wayri/KERO/previews/board-3d.png

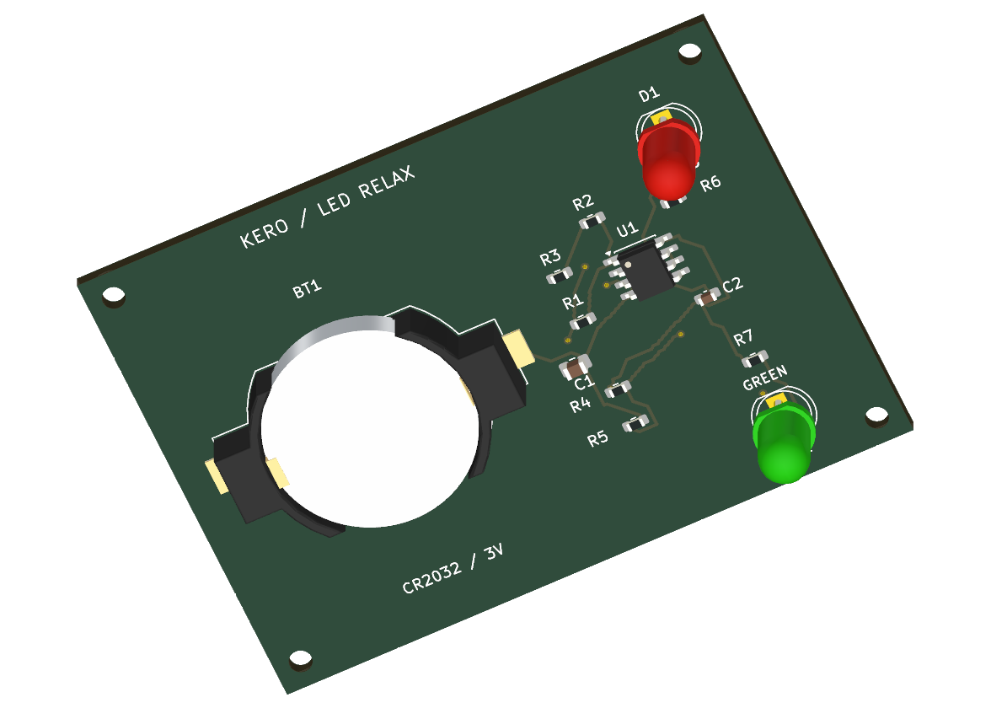
previews/board-3d.png
