wayri/KERO/previews/schematic-browser.png

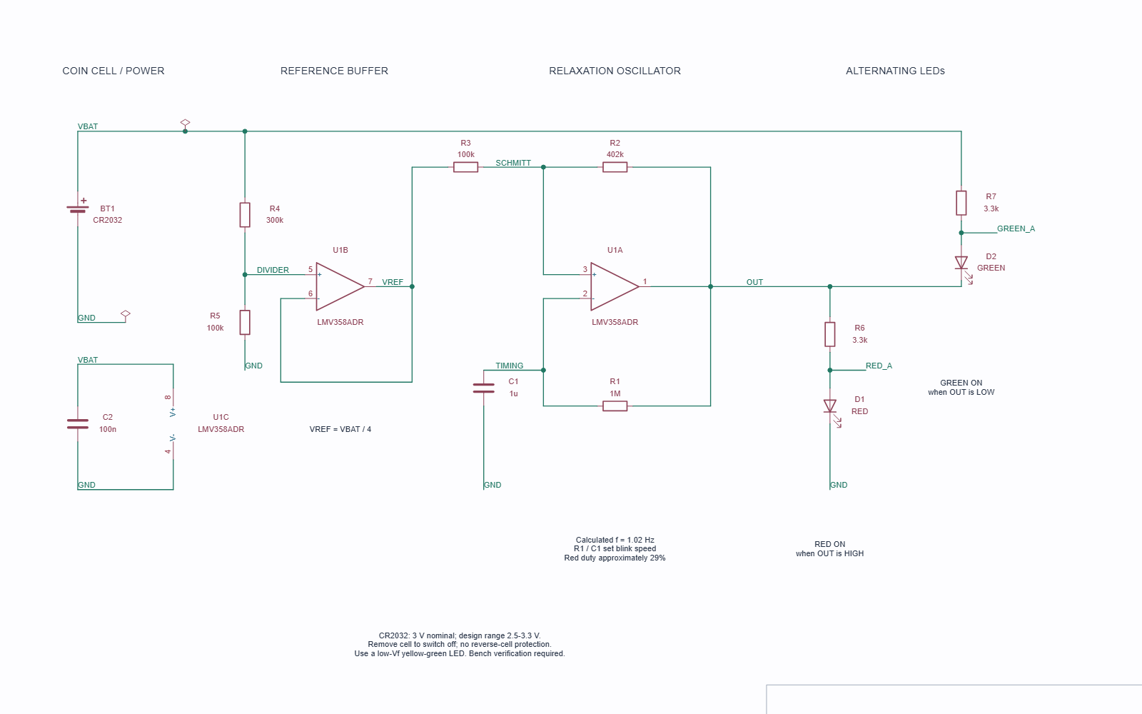
previews/schematic-browser.png
