wayri/KERO/previews/schematic.png

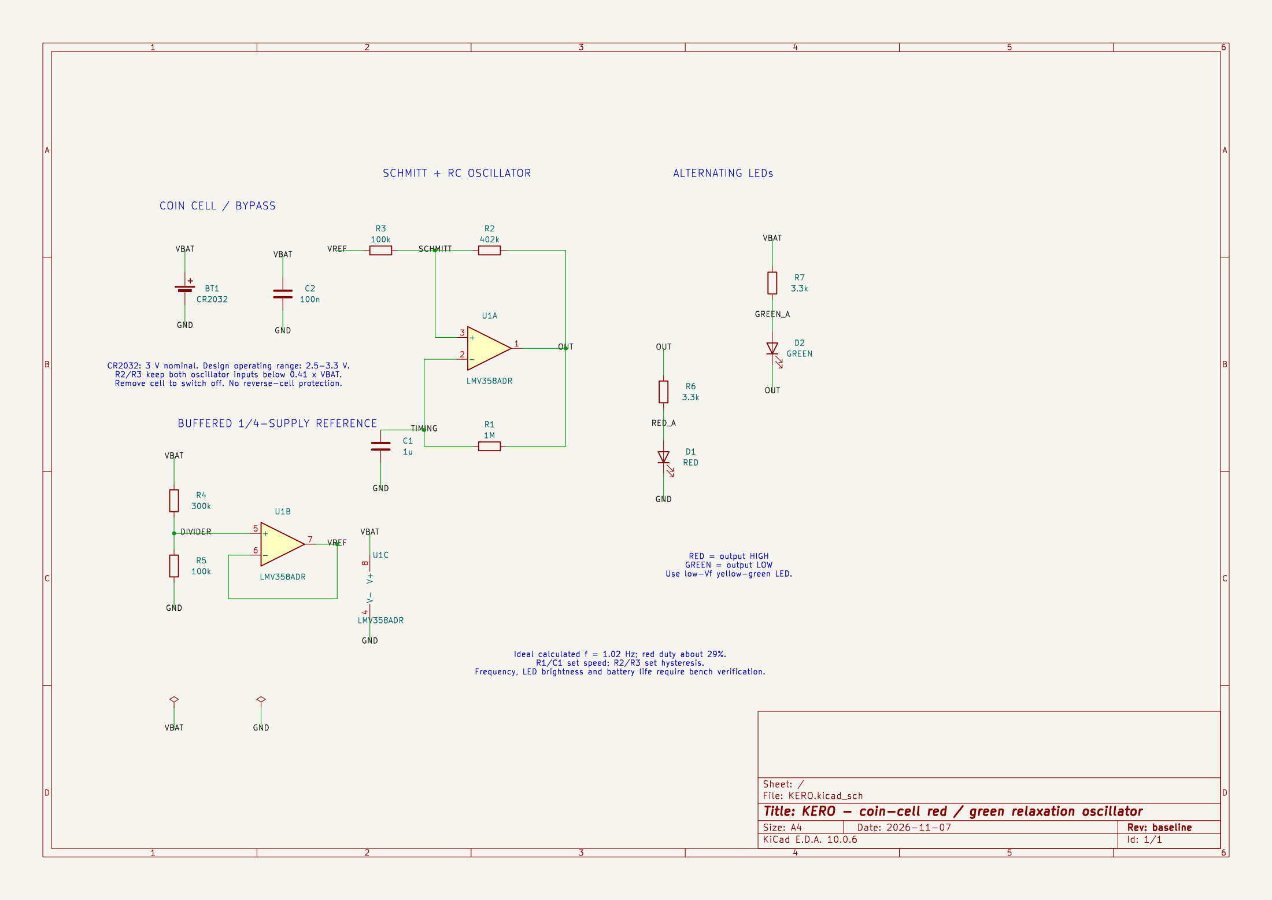
previews/schematic.png
