wayri/KERO/encoder/analysis/power/pi-pad-loads.csv

ref | pin | native_net | rail | sign | mean_A | output_high_mean_A | output_low_mean_A | minimum_A | maximum_A | conservative_positive_peak_A | at_settled_cell_peak_A | ground_assignment | raw_mean_A
U1 | 4 | /VBAT | VBAT | positive draw from VBAT | 4.941771953477701e-05 | 4.931890224634054e-05 | 4.950054830202984e-05 | 4.29172041e-05 | 5.60898958e-05 | 5.60898958e-05 | 5.0983445500000005e-05 | direct passive or supply terminal | 4.941771953477701e-05
U1 | 11 | /GND | GND | positive return into GND | 4.889056466097241e-05 | 4.86239813135539e-05 | 4.911400700219365e-05 | 4.5382140851411135e-05 | 5.4608777617970466e-05 | 5.4608777617970466e-05 | 4.786080884381799e-05 | measured VEE plus inferred global-0 model return | 4.889054643456372e-05
U2 | 4 | /VBAT | VBAT | positive draw from VBAT | 4.830606245981004e-05 | 4.842450602870183e-05 | 4.820678584069054e-05 | 4.32705666e-05 | 5.37561346e-05 | 5.37561346e-05 | 4.93949096e-05 | direct passive or supply terminal | 4.830606245981004e-05
U2 | 11 | /GND | GND | positive return into GND | 5.249522445689346e-05 | 5.1674538799161496e-05 | 5.3183106303421614e-05 | 4.591873997662873e-05 | 6.004030993037191e-05 | 6.004030993037191e-05 | 5.2714900594802676e-05 | measured VEE plus inferred global-0 model return | 5.2495203884841984e-05
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
C14 | 2 | /GND | GND | positive return into GND | 2.6144859284163837e-20 | 2.839436808304793e-20 | 2.4175577250475696e-20 | -7.7532216e-13 | 7.0418079e-13 | 7.0418079e-13 | 4.69794362e-15 | direct passive or supply terminal | 2.6144859284163837e-20
