wayri/KERO/models/LED_D5.0mm_green.step

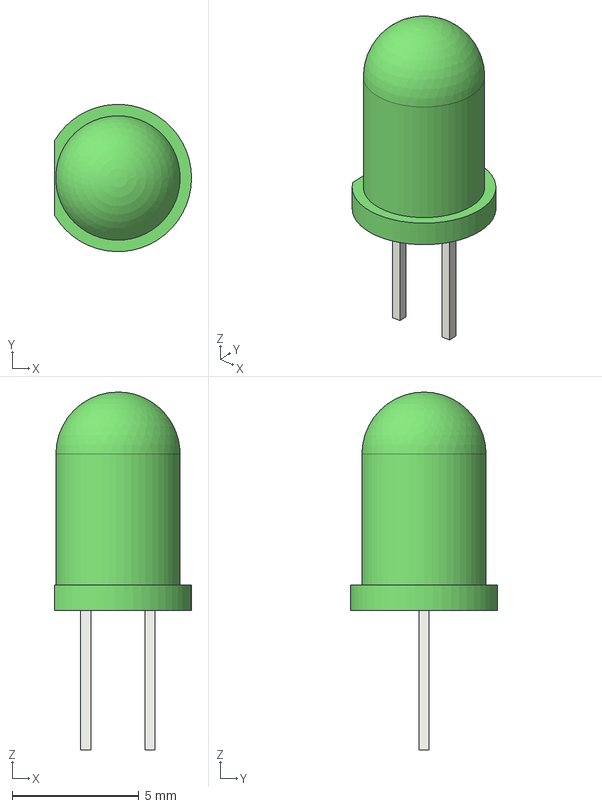
[picture p8: CAD file, 2026-11-07]
models/LED_D5.0mm_green.step
5.40 x 5.79 x 14.1 mm
