wayri/KERO/(list of files, drawings)

Other design files:
encoder/evidence/schematic-visual-review.json
