wayri/KERO/KERO.kicad_pcb

## KiCad design KERO.kicad_pcb (2026-11-09)

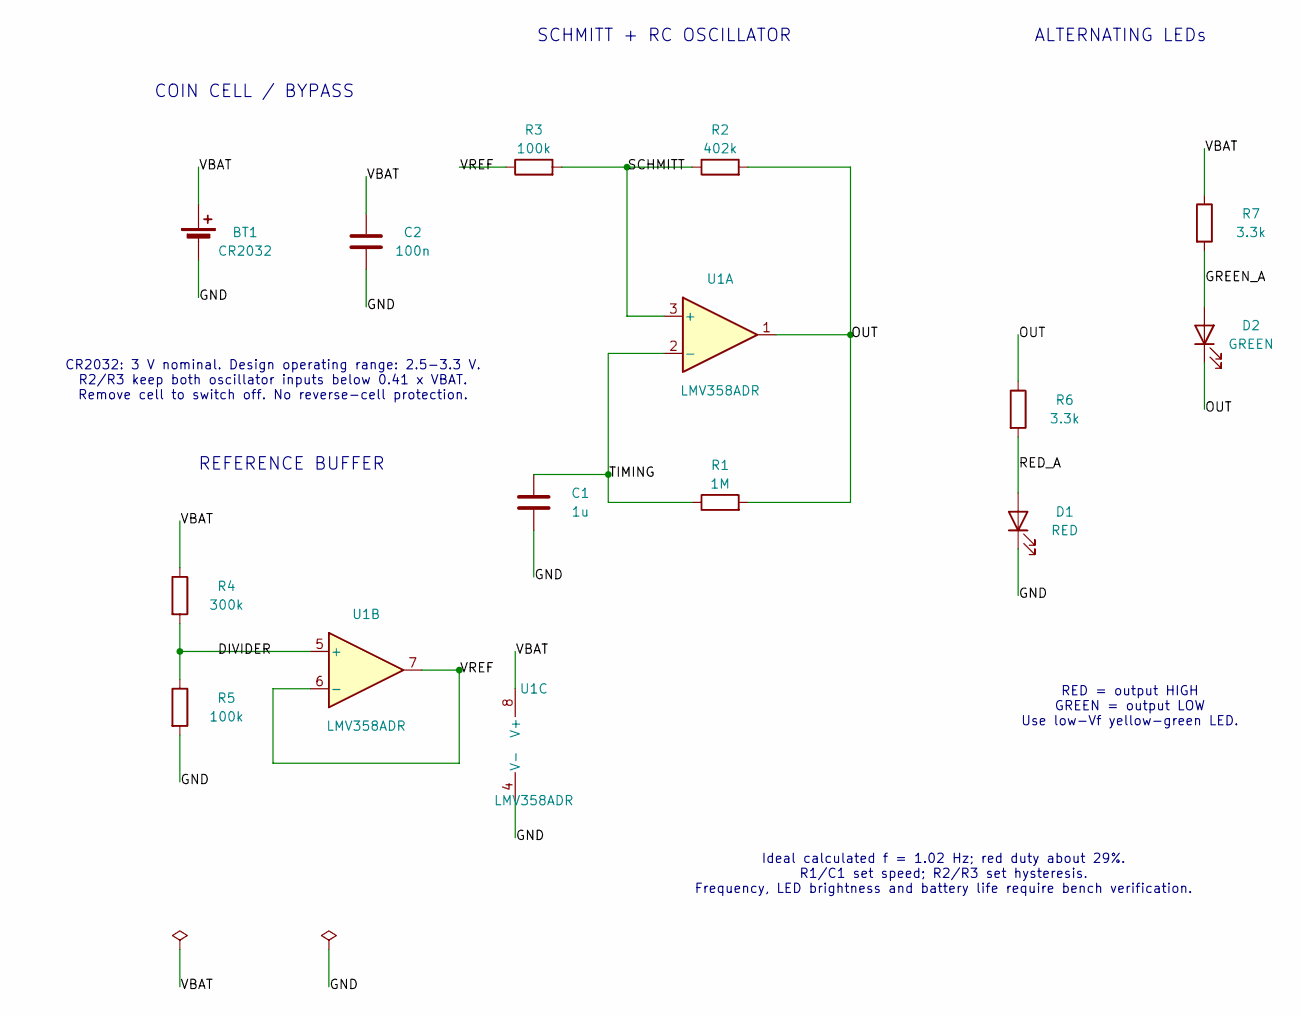
[picture p9: schematic KERO.kicad_sch, KERO - coin-cell red / green relaxation oscillator]

Parts:
BT1: CR2032; BatteryHolder_Keystone_1058_1x2032; Rating Keystone 1058 holder; one CR2032, 3 V n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; MPN 1058
C1: 1u; C_0805_2012Metric; Rating 10 V min, X7R, +/-10%, 0805; effective 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; MPN Select to specification
C2: 100n; C_0603_1608Metric; Rating 10 V min, X7R, +/-10%, 0603; MPN Select to specification
D1: RED; LED_D5.0mm; Rating 5 mm diffused red LED; low-current type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; MPN Select to specification
D2: GREEN; LED_D5.0mm; Rating 5 mm diffused yellow-green LED; Vf <=2.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; MPN Select to specification
R1: 1M; R_0603_1608Metric; Rating 1%, 0.1 W, 0603; MPN Select to specification
R2: 402k; R_0603_1608Metric; Rating 1%, 0.1 W, 0603; MPN Select to specification
R3, R5: 100k; R_0603_1608Metric; Rating 1%, 0.1 W, 0603; MPN Select to specification
R4: 300k; R_0603_1608Metric; Rating 1%, 0.1 W, 0603; MPN Select to specification
R6, R7: 3.3k; R_0603_1608Metric; Rating 1%, 0.1 W, 0603; MPN Select to specification
U1: LMV358ADR; SOIC-8_3.9x4.9mm_P1.27mm; Rating TI LMV358ADR, SOIC-8; 2.5 to 5.5 V; MPN LMV358ADR

Connections:
/DIVIDER: R4.2, R5.1, U1.5 (+)
/GND: BT1.2 (-), C1.2, C2.2, D1.1 (K), R5.2, U1.4 (V-); also elsewhere on the board
/GREEN_A: D2.2 (A), R7.2
/OUT: D2.1 (K), R1.2, R2.2, R6.1, U1.1; also elsewhere on the board
/RED_A: D1.2 (A), R6.2
/SCHMITT: R2.1, R3.2, U1.3 (+)
/TIMING: C1.1, R1.1, U1.2 (-); also elsewhere on the board
/VBAT: BT1.1 (+), C2.1, R4.1, R7.1, U1.8 (V+)
/VREF: R3.1, U1.6 (-), U1.7

Notes on the sheet:
COIN CELL / BYPASS
SCHMITT + RC OSCILLATOR
ALTERNATING LEDs
REFERENCE BUFFER
RED = output HIGH GREEN = output LOW Use low-Vf yellow-green LED.
CR2032: 3 V nominal. Design operating range: 2.5-3.3 V. R2/R3 keep both oscillator inputs below 0.41 x VBAT. Remove cell to switch off. No reverse-cell protection.
Ideal calculated f = 1.02 Hz; red duty about 29%. R1/C1 set speed; R2/R3 set hysteresis. Frequency, LED brightness and battery life require bench verification.

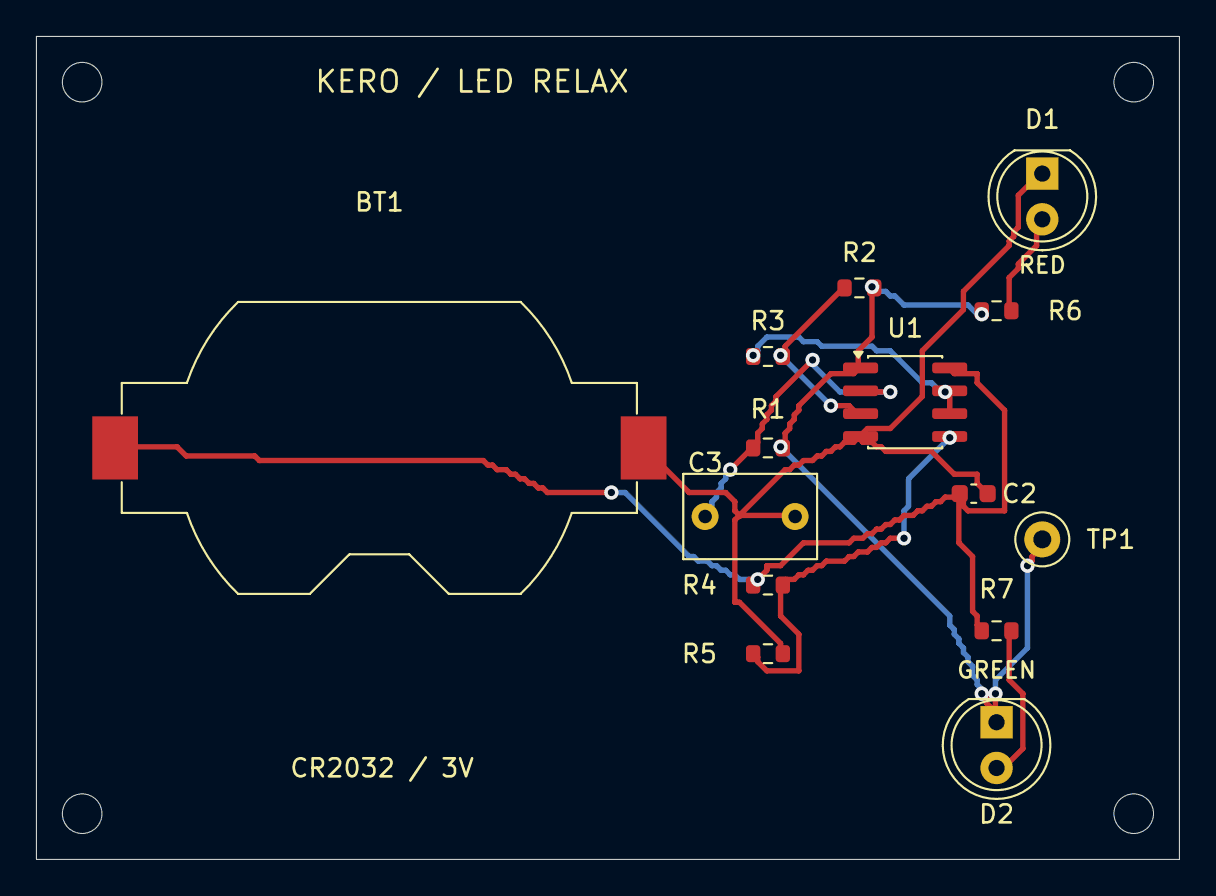
[picture p10: board KERO.kicad_pcb from above]

Board: 2 copper layers, 63.5 x 45.7 mm, 18 parts (0 on the bottom side), 9 nets.

Other parts of the board:
C3: 1u; C_Rect_L7.2mm_W4.5mm_P5.00mm
H1, H2, H3, H4: MountingHole_2.2mm_M2
TP1: OUT; TestPoint_Loop_D2.50mm_Drill1.0mm

Their connections:
/GND: C3.2; also elsewhere on the board
/OUT: TP1.1; also elsewhere on the board
/TIMING: C3.1; also elsewhere on the board
