wayri/KERO/encoder/Encoder.kicad_pcb

## KiCad design encoder/Encoder.kicad_pcb (2026-11-11)

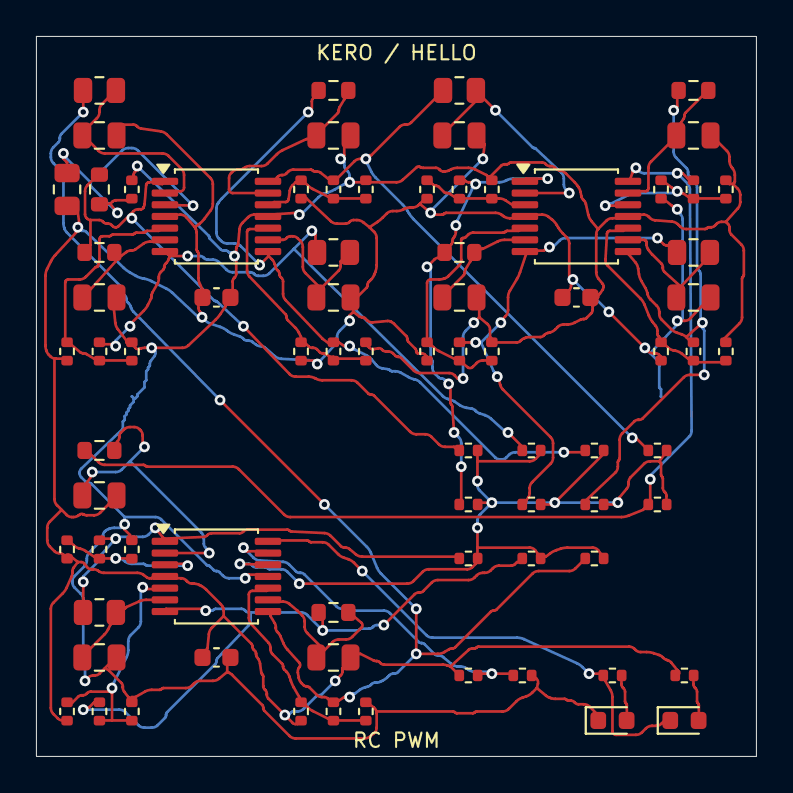
[picture p11: board Encoder.kicad_pcb from above]

Board: 2 copper layers, 40.0 x 40.0 mm, 79 parts (1 on the bottom side), 40 nets.

Parts:
BT1: CR2032; BatteryHolder_Keystone_1058_1x2032
C1, C2, C3, C4, C5, C6, C7, C8, C9, C10, C11: 47n; C_0805_2012Metric
C12, C13, C14: 100n; C_0603_1608Metric
D1: RED; LED_0603_1608Metric
D2: GREEN; LED_0603_1608Metric
R1: 6.98M; R_0805_2012Metric
R2: 2.13M; R_0805_2012Metric
R3: 1.05M; R_0603_1608Metric
R4: 117k; R_0402_1005Metric
R5: 1.65M; R_0603_1608Metric
R6: 365k; R_0402_1005Metric
R7, R26: 208k; R_0402_1005Metric
R8: 412k; R_0402_1005Metric
R9: 3.52M; R_0805_2012Metric
R10: 182k; R_0402_1005Metric
R11: 332k; R_0402_1005Metric
R12: 665k; R_0402_1005Metric
R13: 1.47M; R_0603_1608Metric
R14: 427k; R_0402_1005Metric
R15: 213k; R_0402_1005Metric
R16: 340k; R_0402_1005Metric
R17, R37: 2.43M; R_0805_2012Metric
R18, R38: 240k; R_0402_1005Metric
R19, R39: 258k; R_0402_1005Metric
R20, R40: 511k; R_0402_1005Metric
R21, R29, R33: 2M; R_0603_1608Metric
R22, R27, R30, R34: 291k; R_0402_1005Metric
R23, R31, R35: 229k; R_0402_1005Metric
R24, R32, R36: 459k; R_0402_1005Metric
R25: 2.91M; R_0805_2012Metric
R28: 583k; R_0402_1005Metric
R41: 1.37M; R_0603_1608Metric
R42: 470k; R_0402_1005Metric
R43: 237k; R_0402_1005Metric
R44: 274k; R_0402_1005Metric
R45, R46, R47, R48, R49, R50, R51, R52, R53, R54, R55: 1M; R_0402_1005Metric
R56, R57: 100k; R_0402_1005Metric
R58, R59: 15k; R_0402_1005Metric
U1, U2, U3: TLV9044IPWR; TSSOP-14_4.4x5mm_P0.65mm

Connections:
/GND: BT1.2, C2.2, C4.2, C6.2, C8.2, C10.2, C12.2, C13.2, C14.2, D1.1, R4.2, R8.2, R12.2, R16.2, R20.2, R24.2, R28.2, R32.2, R36.2, R40.2, R44.2, R57.2, U1.11, U2.11, U3.11
/ST01_OUT: R3.2, R5.1, R45.1, U1.1
/ST02_OUT: R7.2, R9.1, R46.1, U1.7
/ST03_OUT: R11.2, R13.1, R47.1, U1.8
/ST04_OUT: R15.2, R17.1, R48.1, U1.14
/ST05_OUT: R19.2, R21.1, R49.1, U2.1
/ST06_OUT: R23.2, R25.1, R50.1, U2.7
/ST07_OUT: R27.2, R29.1, R51.1, U2.8
/ST08_OUT: R31.2, R33.1, R52.1, U2.14
/ST09_OUT: R35.2, R37.1, R53.1, U3.1
/ST10_OUT: R39.2, R41.1, R54.1, U3.7
/ST11_OUT: R1.1, R43.2, R55.1, U3.8
/VBAT: BT1.1, C1.2, C3.2, C5.2, C7.2, C9.2, C11.2, C12.1, C13.1, C14.1, R2.1, R6.1, R10.1, R14.1, R18.1, R22.1, R26.1, R30.1, R34.1, R38.1, R42.1, R56.1, R59.1, U1.4, U2.4, U3.4
/bank1/ST01_TH: R2.2, R3.1, R4.1, U1.3
/bank1/ST01_TIMING: C1.1, R1.2, U1.2
/bank1/ST02_TH: R6.2, R7.1, R8.1, U1.5
/bank1/ST02_TIMING: C2.1, R5.2, U1.6
/bank1/ST03_TH: R10.2, R11.1, R12.1, U1.10
/bank1/ST03_TIMING: C3.1, R9.2, U1.9
/bank1/ST04_TH: R14.2, R15.1, R16.1, U1.12
/bank1/ST04_TIMING: C4.1, R13.2, U1.13
/bank2/ST05_TH: R18.2, R19.1, R20.1, U2.3
/bank2/ST05_TIMING: C5.1, R17.2, U2.2
/bank2/ST06_TH: R22.2, R23.1, R24.1, U2.5
/bank2/ST06_TIMING: C6.1, R21.2, U2.6
/bank2/ST07_TH: R26.2, R27.1, R28.1, U2.10
/bank2/ST07_TIMING: C7.1, R25.2, U2.9
/bank2/ST08_TH: R30.2, R31.1, R32.1, U2.12
/bank2/ST08_TIMING: C8.1, R29.2, U2.13
/bank3/ST09_TH: R34.2, R35.1, R36.1, U3.3
/bank3/ST09_TIMING: C9.1, R33.2, U3.2
/bank3/ST10_TH: R38.2, R39.1, R40.1, U3.5
/bank3/ST10_TIMING: C10.1, R37.2, U3.6
/bank3/ST11_TH: R42.2, R43.1, R44.1, U3.10
/bank3/ST11_TIMING: C11.1, R41.2, U3.9
/decoder/GREEN_A: D2.2, R59.2
/decoder/MAJORITY_SUM: R45.2, R46.2, R47.2, R48.2, R49.2, R50.2, R51.2, R52.2, R53.2, R54.2, R55.2, U3.12
/decoder/MIDREF: R56.2, R57.1, U3.13
/decoder/RED_A: D1.2, R58.2
ENCODED_OUT: D2.1, R58.1, U3.14
