wayri/KERO/(commit log)

2026-11-07 feat: draw the CR2032 LMV358A relaxation oscillator and document its BoM
2026-11-07 feat: route the two-layer PCB and vendor portable component models
2026-11-07 fix: redraw the schematic with visible wiring and clean functional groups
2026-11-07 docs: add revision-specific assembly and polarity instructions
2026-11-07 docs: add an honest bring-up record and documentation-only compare case
2026-11-07 feat: reduce LED current with 4.7k series resistors
2026-11-07 feat: assign Vishay manufacturer part numbers to the LED resistors
2026-11-07 fix: preserve unchanged native footprint fields in the BoM comparison
2026-11-07 feat: add a routed output probe point with portable 3D geometry
2026-11-07 feat: replace the timing capacitor and repair its plated-lead routing
2026-11-07 feat: save WayriCAD PI fields and the coin-cell power budget for review
2026-11-07 fix: include either LED state when reporting peak cell current
2026-11-07 feat: save QuickTherm temperature fields and native study files
2026-11-07 feat: validate an RC and op-amp only hello world pulse encoder
2026-11-07 Add six-sheet RC hello-world encoder schematic and portable BoM
2026-11-07 Add compact encoder PCB candidate with explicit routing gaps
2026-11-07 Close encoder routing and verify zero ERC DRC and open connections
2026-11-07 Save encoder cell-current budget and source-bound WayriCAD PI studies
2026-11-07 Save encoder QuickTherm fields reports and analysis provenance
2026-11-09 docs: describe merged RC pulse encoder capability in README
2026-11-09 docs: make encoder visuals and specifications the primary README
2026-11-11 Smooth encoder routing with native arcs and record the default convention
